asherniedzwiedz-sys/Hatch-Alarm-Clock/Sunrise_Clock_Parts.xlsx

Sheet: Parts
Sunrise Clock: parts, Amazon vs AliExpress |  |  | Total: | $52.03
One clock, every function. Prices checked 2026-10-20 on amazon.com and aliexpress.us (AliExpress: regular price, not the one-time new-shopper deal). Prices change. ESP32 and PLA not included (you have them).
Part | Qty | Amazon listing | Amazon $ | Amazon quality | AliExpress listing | AliExpress $ | AliExpress quality | AliExpress option to pick | Amazon − AliExpress | My pick | My price | Notes
LED strip, WS2812B, 1 m, 10 mm wide | 1 | BTF-Lighting 100 LED/m IP30 (https://www.amazon.com/dp/B088B8G8LD) | $11.99 | 4.6★ | ANTVLED 96 LED/m IP30 (https://www.aliexpress.us/item/3256807796309465.html) | $4.75 | 4.8★, 5,000+ sold | 1m 96 IP30 | $7.24 | AliExpress | $4.75 | BTF is a known brand, consistent color. Ali store 94.8% positive. Both strips fit the channels.
74AHCT125 level shifter (DIP-14) | 1 | 10 pcs (https://www.amazon.com/dp/B08R6BCSYC) | $7.99 | 4.7★ | 5 pcs (https://www.aliexpress.us/item/3256807469514168.html) | $2.41 | 4.9★, 2,000+ sold | 5 pcs | $5.58 | AliExpress | $2.41 | Cheap chips can be relabeled 74HC parts that won't shift 3.3 V to 5 V. First suspect if the LEDs flicker.
MAX98357A I2S amplifier | 1 | 2 pcs (https://www.amazon.com/dp/B0DPJRLMDJ) | $6.88 | 4.5★ | 1 pc (https://www.aliexpress.us/item/3256807442706139.html) | $2.34 | 4.8★, 4,000+ sold |  | $4.54 | AliExpress | $2.34 | Same board design
Speaker, 2" 4 Ω 3 W | 1 | Gikfun EK1725, 2 pcs (https://www.amazon.com/dp/B01CHYIU26) | $11.49 | 4.3★, 776 reviews | SOTAMIA 50 mm, 2 pcs (https://www.aliexpress.us/item/3256808046771474.html) | $7.34 | 528 sold | 4 Ohm 3W | $4.15 | Amazon | $11.49 | Gikfun is better proven. Both fit the seat (glue it in).
DS3231 RTC (ZS-042) | 1 | 2 pcs + jumper wires (https://www.amazon.com/dp/B09LLMYBM1) | $7.99 | 4.4★ | 1 pc, Choice (https://www.aliexpress.us/item/3256806957282138.html) | $3.14 | 4.8★, 4,000+ sold, Choice | DS3231SN, blue board with coin-cell holder | $4.85 | AliExpress | $3.14 | DS3231M chips are less accurate but still work. Remove the charging resistor for a CR2032.
KY-040 rotary encoder | 1 | 5 pcs (https://www.amazon.com/dp/B06XQTHDRR) | $9.39 | 4.5★ | 1 pc + knob (https://www.aliexpress.us/item/2255800145982269.html) | $1.48 | 4.7★, 1,000+ sold |  | $7.91 | AliExpress | $1.48 | Same module, with the pull-ups GPIO34/35 need
12 mm momentary push buttons | 2 | Gebildet 5 pcs, Flat Head (SS-Momentary-5pcs) (https://www.amazon.com/dp/B0B8Z14K3T) | $7.99 | 4.6★, 981 reviews | 1 pc each, price for 2 (https://www.aliexpress.us/item/2251832630370510.html) | $4.40 | 90 sold | Momentary | $3.59 | Amazon | $7.99 | Amazon's are much better reviewed. Weakest AliExpress listing.
USB-C power input, dual 5.1 kΩ | 1 | eleUniverse 2 pcs (https://www.amazon.com/dp/B0GR8SNSCQ) | $8.90 | no reviews yet | Type-C board, CC1/CC2 5.1K, Choice (https://www.aliexpress.us/item/3256805787035895.html) | $2.86 | 5★, 347 sold, Choice | with 5.1K resistors | $6.04 | AliExpress | $2.86 | AliExpress listing has the better track record here
HLK-LD2410C sleep radar | 1 | AEDIKO 2 pcs (https://www.amazon.com/dp/B0GQYYTJPS) | $13.99 | 4.6★, 9 reviews | 1 pc, Choice (https://www.aliexpress.us/item/3256806849046153.html) | $5.91 | 4.8★, 5,000+ sold, Choice | LD2410C (not B or 2420) | $8.08 | AliExpress | $5.91 | Same Hi-Link module. Pocket is 22 × 16 mm: measure yours.
Jumper wires, female-female | 1 | 40 pcs, 20 cm (https://www.amazon.com/dp/B0BRTJQGS6) | $3.99 | 4.8★ | 40 pin (https://www.aliexpress.us/item/3256812379729214.html) | $3.32 |  | F-F 20cm | $0.67 | AliExpress | $3.32 | Same
Protoboards | 1 | 58 pcs kit + headers (https://www.amazon.com/dp/B0CKZ7GFSK) | $13.99 | 4.6★ | 5 pcs (https://www.aliexpress.us/item/3256808585524708.html) | $4.15 | 560 sold | 3x7cm | $9.84 | AliExpress | $4.15 | Amazon kit includes headers and terminals
Total (core build) |  |  | $119.57 |  |  | $51.15 |  |  | $68.42 |  | $58.89 | My price = your mix. Default: AliExpress, except the speaker and buttons from Amazon.
Optional
BH1750 light sensor (auto-dim, optional) | 1 | HiLetgo 3 pcs (https://www.amazon.com/dp/B00M0F29OS) | $7.49 | 4.5★ | GY-302, Choice (https://www.aliexpress.us/item/3256810260002611.html) | $2.19 | 5★, 414 sold, Choice | GY-302 | $5.30 | AliExpress | $2.19 | Only needed for auto-dim
Total with optional parts |  |  | $127.06 |  |  | $53.34 |  |  | $73.72 |  | $61.08
Same on both sites (not in the totals)
OPEN-SMART 0.8" Inch 16x8 I2C LED Dot Matrix Display Module 4 Pin Red LED Matrix for Arduino (https://www.aliexpress.us/item/3256804212916663.html)
Dot-matrix clock: Adafruit 0.8" 8x16 LED Matrix FeatherWing kit, white (https://www.adafruit.com/product/3149) |  |  | $19.95 |  |  |  |  |  |  |  |  | adafruit.com, plus shipping. Neither site had a good match.
…or the yellow version (cheaper) (https://www.adafruit.com/product/3153) |  |  | $11.95 |  |  |  |  |  |  |  |  | adafruit.com, plus shipping
5 V 3 A USB-C power supply (https://www.amazon.com/dp/B09JW4QQJ2) |  |  | $9.99 | think I can find |  |  |  |  |  |  |  | Free if you have a USB-C phone charger that does 5 V 3 A
Fabric: muslin, 1.3 yd (https://www.amazon.com/dp/B0G8HGNHWH) |  |  | $6.99 | can find |  |  |  |  |  |  |  | Free with an old linen shirt or pillowcase. Hold it up to a lamp: it should glow.
CR2032 coin cells, 24 pack (https://www.amazon.com/dp/B0F28618FV) |  |  | $7.99 | can find |  |  |  |  |  |  |  | Free if you have one at home
M3 heat-set inserts | 1 | 100 pcs, M3 × 5.7 × 4.6 (https://www.amazon.com/dp/B0DQL4ZSCP) | $5.99 | can find | brass inserts (https://www.aliexpress.us/item/3256804349544912.html) | $3.40 | 54,000+ sold | M3 (OD 4.5mm) 50pcs, Length 5mm | $2.59 | AliExpress | $3.40 | Holes are Ø4.0 × 5 mm: a 5 mm insert sits flush. OD 5 mm or wider can split the posts.
M3 countersunk screws | 1 | 630 pcs kit (https://www.amazon.com/dp/B0F8HPFXX5) | $8.99 | can find | kit (https://www.aliexpress.us/item/3256805779852270.html) | $5.65 | 4.8★, 1,000+ sold | M3 | $3.34 | AliExpress | $5.65 | Same
470 Ω resistor | 1 | California JOS 100 pcs (https://www.amazon.com/dp/B0B4FSVCPT) | $3.99 | can find | 100 pcs metal film (https://www.aliexpress.us/item/3256809879566136.html) | $1.84 | 550 sold | 470R | $2.15 | AliExpress | $1.84 | Same part
1000 µF 16 V capacitor | 1 | 10 pcs, low ESR (https://www.amazon.com/dp/B0D78PBK4K) | $5.99 | can find | DIP electrolytic (https://www.aliexpress.us/item/3256811625053645.html) | $2.75 | 4.8★, 5,000+ sold | 16V 1000uF | $3.24 | AliExpress | $2.75 | Same part
How to use
Yellow cells (My pick): choose Amazon, AliExpress or None from the dropdown. My price and its total update.
Blue numbers are prices typed in from the listings on 2026-10-20; black numbers are formulas.
Click a listing name to open it. On AliExpress, choose the option in the 'AliExpress option to pick' column.
Quality: most are the same boards on both sites. Amazon = fast, free returns, spares. AliExpress = ~60% cheaper, test parts on arrival.

Sheet: Buying
Sunrise Clock: parts, Amazon vs AliExpress |  |  | Total: | $58.55
One clock, every function. Prices checked 2026-10-20 on amazon.com and aliexpress.us (AliExpress: regular price, not the one-time new-shopper deal). Prices change. ESP32 and PLA not included (you have them).
Part | Qty | listing | Price | My pick | Option to pick
LED strip, WS2812B, 1 m, 10 mm wide | 1 | ANTVLED 96 LED/m IP30 (https://www.aliexpress.us/item/3256807796309465.html) | $4.75 | AliExpress | White PCB, 1m 96 IP30
74AHCT125 level shifter (DIP-14) | 1 | 5 pcs (https://www.aliexpress.us/item/3256807469514168.html) | $2.41 | AliExpress | 5PCS SN74AHCT125N
MAX98357A I2S amplifier | 1 | 1 pc (https://www.aliexpress.us/item/3256807442706139.html) | $2.34 | AliExpress | 1PCS
Speaker, 2" 4 Ω 3 W | 1 | Gikfun EK1725, 2 pcs (https://www.amazon.com/dp/B01CHYIU26) | $11.49 | Amazon | 2 pcs
DS3231 RTC (ZS-042) | 1 | 1 pc, Choice (https://www.aliexpress.us/item/3256806957282138.html) | $3.14 | AliExpress | only one option
KY-040 rotary encoder | 1 | 1 pc + knob (https://www.aliexpress.us/item/2255800145982269.html) | $1.48 | AliExpress | only one option
12 mm momentary push buttons | 2 | Gebildet 5 pcs (pick Flat Head) (https://www.amazon.com/dp/B0B8Z14K3T/) | $7.99 | Amazon | SS-Momentary-5pcs (Flat Head)
USB-C power input, dual 5.1 kΩ | 1 | Type-C board, CC1/CC2 5.1K, Choice (https://www.aliexpress.us/item/3256805787035895.html) | $2.86 | AliExpress | army green (blue board), 1PCS
HLK-LD2410C sleep radar | 1 | 1 pc, Choice (https://www.aliexpress.us/item/3256806849046153.html) | $5.91 | AliExpress | 1pc
Jumper wires, female-female | 1 | 40 pin (https://www.aliexpress.us/item/3256812379729214.html) | $3.32 | AliExpress | 20CM Female-Female, 1Set-40Pin
Protoboards | 1 | 5 pcs (https://www.aliexpress.us/item/3256808585524708.html) | $4.15 | AliExpress | Red 3x7cm, 5PCS
M3 heat-set inserts | 1 | brass inserts (https://www.aliexpress.us/item/3256804349544912.html) | $3.40 | AliExpress | M3 (OD 4.5mm) 50pcs, Length 5mm
Male header pins | 1 | Male header pins (https://www.aliexpress.us/item/3256801327743339.html) | $3.12 |  | 11.5mm 10pcs
Total (core build) |  |  | $56.36
BH1750 light sensor (auto-dim, optional) | 1 | GY-302, Choice (https://www.aliexpress.us/item/3256810260002611.html) | $2.19 | AliExpress | GY-302 1PCS
Total with optional parts |  |  | $58.55
Same on both sites (not in the totals)
Dot Matrix Display (https://www.aliexpress.us/item/3256804212916663.html) | 1 | Dot Matrix Display (https://www.aliexpress.us/item/3256804212916663.html) | $2.82 | AliExpress | most likely buying
Dot-matrix clock: Adafruit 0.8" 8x16 LED Matrix FeatherWing kit, white (https://www.adafruit.com/product/3149) |  |  | $19.95
…or the yellow version (cheaper) (https://www.adafruit.com/product/3153) |  |  | $11.95
5 V 3 A USB-C power supply (https://www.amazon.com/dp/B09JW4QQJ2) |  |  | $9.99 | think I can find
Fabric: muslin, 1.3 yd (https://www.amazon.com/dp/B0G8HGNHWH) |  |  | $6.99 | can find
CR2032 coin cells, 24 pack (https://www.amazon.com/dp/B0F28618FV) |  |  | $7.99 | can find
M3 countersunk screws | 1 | 630 pcs kit (https://www.amazon.com/dp/B0F8HPFXX5) | $8.99 | can find | kit (https://www.aliexpress.us/item/3256805779852270.html) | $5.65 | AliExpress
470 Ω resistor | 1 | California JOS 100 pcs (https://www.amazon.com/dp/B0B4FSVCPT) | $3.99 | can find | 100 pcs metal film (https://www.aliexpress.us/item/3256809879566136.html) | $1.84 | AliExpress
1000 µF 16 V capacitor | 1 | 10 pcs, low ESR (https://www.amazon.com/dp/B0D78PBK4K) | $5.99 | can find | DIP electrolytic (https://www.aliexpress.us/item/3256811625053645.html) | $2.75 | AliExpress
How to use
Yellow cells (My pick): choose Amazon, AliExpress or None from the dropdown. My price and its total update.
Blue numbers are prices typed in from the listings on 2026-10-20; black numbers are formulas.
Click a listing name to open it. On AliExpress, choose the option in the 'AliExpress option to pick' column.
Quality: most are the same boards on both sites. Amazon = fast, free returns, spares. AliExpress = ~60% cheaper, test parts on arrival.
