asherniedzwiedz-sys/Hatch-Alarm-Clock/enclosure/stl/knob.stl

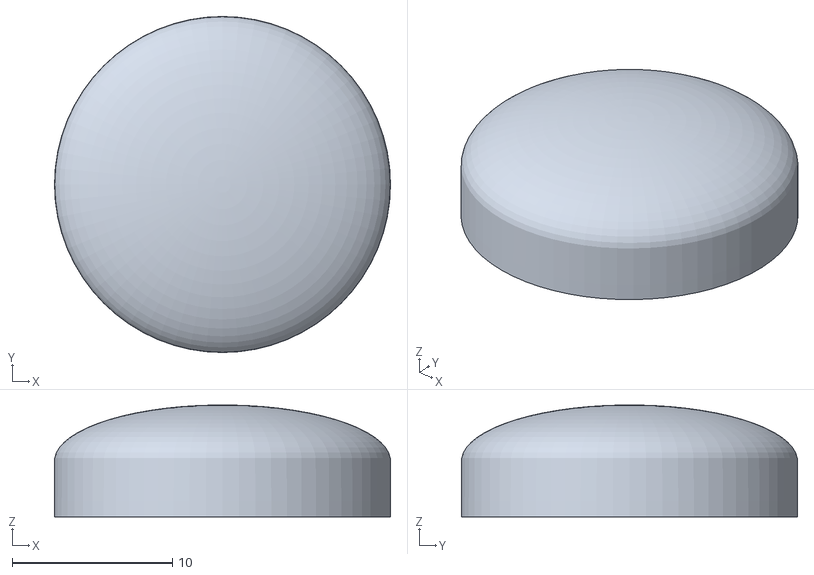
[picture p1: CAD file, 2026-10-21]
enclosure/stl/knob.stl
21.0 x 21.0 x 7.00
