asherniedzwiedz-sys/Hatch-Alarm-Clock/enclosure/sunrise_clock_A1.3mf

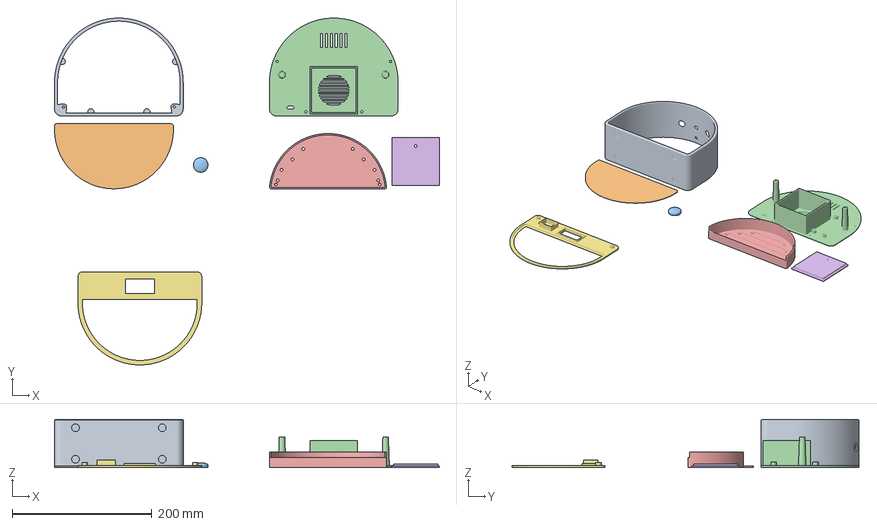
[picture p2: CAD file, 2026-10-21]
enclosure/sunrise_clock_A1.3mf
550.2 x 495.7 x 69.0 mm
diffuser
knob
back_cover
light_box
speaker_lid
frame
