asherniedzwiedz-sys/Hatch-Alarm-Clock/enclosure/stl/speaker_lid.stl

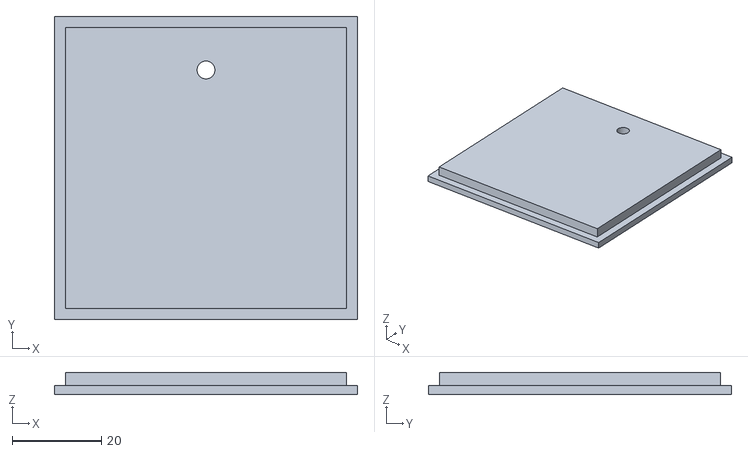
[picture p3: CAD file, 2026-10-21]
enclosure/stl/speaker_lid.stl
68.0 x 68.0 x 5.00
