asherniedzwiedz-sys/Hatch-Alarm-Clock/enclosure/stl/frame.stl

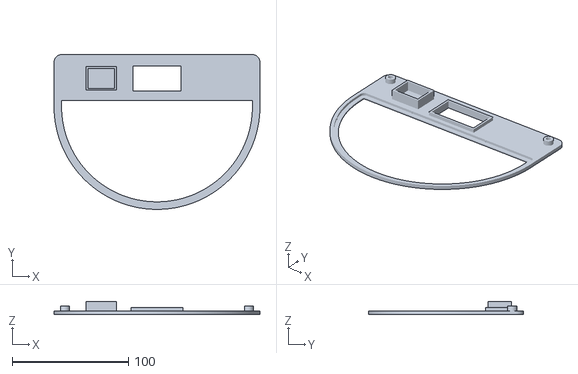
[picture p4: CAD file, 2026-10-21]
enclosure/stl/frame.stl
177.0 x 133.0 x 11.2
