asherniedzwiedz-sys/Hatch-Alarm-Clock/enclosure/stl/back_cover.stl

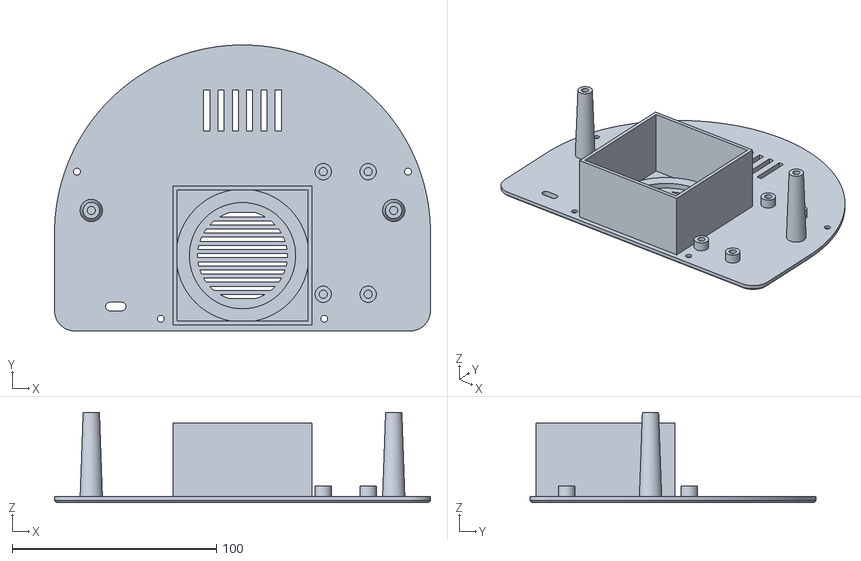
[picture p5: CAD file, 2026-10-21]
enclosure/stl/back_cover.stl
184.0 x 140.0 x 44.1
