asherniedzwiedz-sys/Hatch-Alarm-Clock/enclosure/stl/light_box.stl

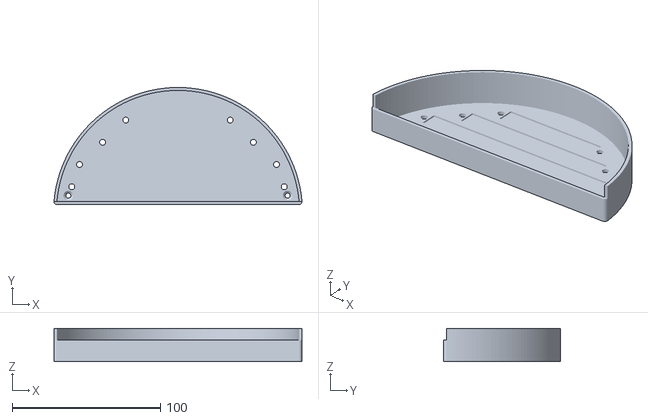
[picture p6: CAD file, 2026-10-21]
enclosure/stl/light_box.stl
167.4 x 79.0 x 22.5
