asherniedzwiedz-sys/Hatch-Alarm-Clock/enclosure/stl/shell.stl

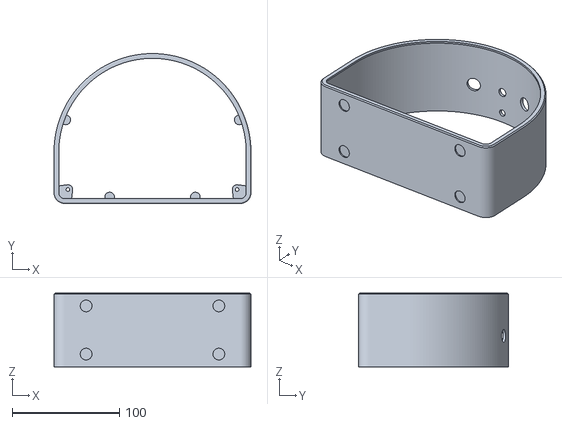
[picture p7: CAD file, 2026-10-21]
enclosure/stl/shell.stl
184.0 x 140.0 x 69.0
