asherniedzwiedz-sys/Hatch-Alarm-Clock/enclosure/stl/diffuser.stl

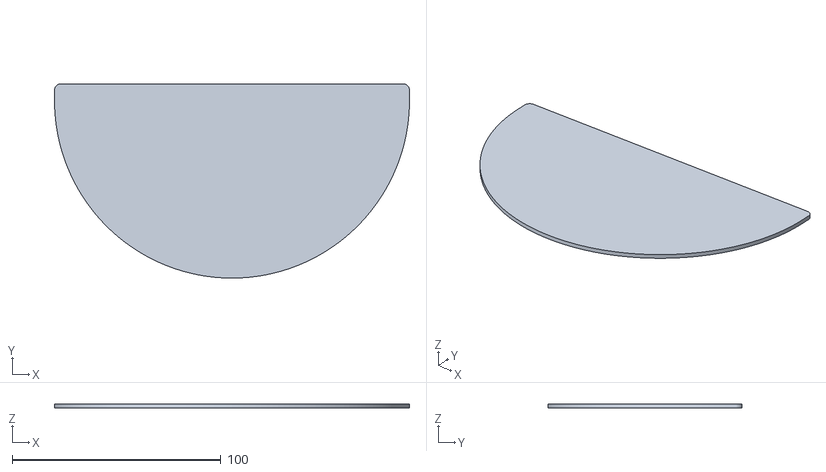
[picture p8: CAD file, 2026-10-20]
enclosure/stl/diffuser.stl
170.0 x 93.0 x 2.00
