asherniedzwiedz-sys/Hatch-Alarm-Clock/(commit log)

2026-10-20 Hatch-style DIY sunrise alarm clock: firmware, web UI, enclosure
    ESP32 firmware (PlatformIO, Arduino-ESP32 2.0.17): 30-min sunrise ramp,
    synthesized chime, SD sleep sounds with sleep timer, night light, DS3231 RTC
    alarms in NVS, dot-matrix clock, LD2410C radar sleep tracking, web UI + OTA.
    OpenSCAD arch enclosure with exported STLs, assembly guide and check script.
    [back_cover.stl, diffuser.stl, frame.stl, knob.stl, light_box.stl, shell.stl, speaker_lid.stl, sunrise_clock.scad]
2026-10-20 Bambu Studio project: all parts on 3 plates for the A1
    sunrise_clock_A1.3mf puts the 7 STLs on 3 plates (white x2, black frame) with
    Bambu's 0.20mm Standard @BBL A1 settings and two PLA Basic slots. make_3mf.py
    rebuilds it from the STLs and checks every part is manifold, on its plate and
    not overlapping. Script paths are now cwd-relative.
    [sunrise_clock_A1.3mf]
2026-10-20 Fit the model to the parts on the shopping list; add PARTS.md
    - Speaker seat for the Gikfun 2" 4 ohm 3 W (no 57 mm driver on Amazon).
    - LED rows for the BTF-Lighting 100 LED/m, 10 mm strip (still 13/12/9/6).
    - Clock pocket is a 3 mm rim so the Adafruit FeatherWing board clears it;
    that board runs from 3V3, so no I2C level shifter.
    - PARTS.md: checked Amazon picks with links, and what isn't on Amazon.
    [back_cover.stl, frame.stl, knob.stl, light_box.stl, shell.stl, speaker_lid.stl, sunrise_clock.scad, sunrise_clock_A1.3mf]
2026-10-20 Shell: corner screw bosses become columns from the print bed
    Bambu Studio flagged a floating cantilever: the frame's corner bosses had flat
    undersides ~20 mm wide, 45 mm above the bed when printed back-down. They now
    rise straight from the back rim, with a countersunk seat (45 deg ceiling) and a
    driver channel from the open back. overhangs.py checks every STL for surfaces
    that need support.
    [back_cover.stl, frame.stl, knob.stl, light_box.stl, shell.stl, speaker_lid.stl, sunrise_clock.scad, sunrise_clock_A1.3mf]
2026-10-21 Built-in sleep sounds: synthesize white/pink/rain/ocean/fan on the ESP32
    The SD module and card are now optional (only for your own WAVs), which cuts
    ~$27 and their wiring. SoundSynth.h is pure and tested natively: each sound
    sits at -20 dBFS +-2 dB with no DC or clipping. PARTS.md gets a lean build.
2026-10-21 Parts: Amazon vs AliExpress comparison; LED channels fit 96 and 100/m
    PARTS.md compares the lean build part by part: $129.55 on Amazon vs $50.41 on
    AliExpress (plus the Adafruit clock on either), with quality notes. The light
    box channels are sized for 96 LED/m, so the AliExpress strip fits and the
    Amazon 100/m strip still does.
    [back_cover.stl, frame.stl, knob.stl, light_box.stl, shell.stl, speaker_lid.stl, sunrise_clock.scad, sunrise_clock_A1.3mf]
2026-10-21 Add the parts list as an Excel workbook
    Sunrise_Clock_Parts.xlsx: every part with Amazon and AliExpress links, prices
    and quality notes, a per-part pick dropdown, and live totals. Recalculated in
    Excel: 40 formulas, no errors.
    [Sunrise_Clock_Parts.xlsx]
2026-10-21 Swap four AliExpress parts to Choice listings
    Single-seller listings each charged $4-6 shipping; Choice items ship
    together. Radar, RTC, USB-C board and light sensor updated in the
    spreadsheet and PARTS.md.
    [Sunrise_Clock_Parts.xlsx]
2026-10-21 Parts: final buy list, OPEN-SMART I2C clock
    PARTS.md gets the checked final list with the option to pick per
    listing. The clock is now the OPEN-SMART 0.8" 16x8 I2C board
    (HT16K33-compatible), with Adafruit's FeatherWing as the alternative.
    Buttons link to the Flat Head listing, the USB-C board option is the
    blue one with visible CC resistors, and the inserts are M3 OD 4.5 x 5 mm.
    The workbook adds the Buying tab, with tracking parameters stripped
    from the links.
    [Sunrise_Clock_Parts.xlsx]
2026-10-21 Screw lengths: allowed range per spot, checked against the model
    The ESP32 standoffs take M3x5-6 (M3x8 bottoms out in the 6 mm hole
    under a 1.6 mm board). The back cover and light box take M3x6-8
    (M3x10 bottoms out). The shopping list is now 2 x M3x10, 6 x M3x8 and
    4 x M3x6 instead of 10 x M3x8.
2026-10-21 Workbook: fix circular totals and stale Parts-tab cells
    Parts row 16 summed rows 5-30, which included itself, so its totals
    came out blank. It now sums the part rows plus the inserts and
    screws. The Parts tab also gets the $4.75 strip price, the Flat Head
    button link, and the M3 OD 4.5 x 5 mm insert at $3.40, matching the
    Buying tab.
    [Sunrise_Clock_Parts.xlsx]
2026-10-21 Clock: find the board at any address 0x70-0x77; log brownout resets
    Clone HT16K33-type boards (e.g. the OPEN-SMART 16x8 I2C) may ship
    with different address jumpers, so begin() now tries the whole range
    and prints where it answered. Boot also says when the last reset was a
    brownout, the likeliest failure at full light plus chime plus Wi-Fi.
    Builds with 0 warnings; 15/15 native tests pass.
    [ClockDisplay.cpp, ClockDisplay.h, Config.h, main.cpp]
2026-10-21 Bench test guide and Wokwi simulation
    BENCH_TEST.md walks through testing before soldering: first in the
    Wokwi simulator (no parts needed), then module by module on the desk.
    The wokwi env builds with -DWOKWI and merges bootloader, partitions,
    app and the LittleFS web page into one image (tools/wokwi_merge.py).
    Simulator-only behavior: join Wokwi-GUEST, accept the localhost port
    forward, and add a one-time alarm 3 minutes out so the sunrise and
    ring can be checked right away. The real build is unchanged apart
    from 3 amber blinks after a brownout reset.
    Both envs build with 0 warnings; 15/15 native tests pass. The
    simulation itself hasn't been run here (it needs a Wokwi license).
    Co-Authore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
    [AlarmScheduler.h, WebUI.cpp, main.cpp]
2026-10-22 Wokwi: drive 2 LEDs; print alarm phase changes
    In the simulator the 40-LED strip stayed dark with the firmware while
    an Adafruit NeoPixel test sketch lit it on the same wiring. 2 LEDs fit
    one RMT memory block, so the sim build no longer depends on refill
    interrupts. Untested in Wokwi yet. Phase changes now go to serial in
    both builds, for the bench test.
    [Config.h, main.cpp]
2026-10-22 Wokwi: no SNTP, so the RTC's local time doesn't jump to UTC mid-test
    The simulator's DS1307 starts at the PC's local time, which the firmware
    reads as UTC. SNTP then corrected it by the UTC offset, the 3-minute test
    alarm moved hours away, and the sunrise ended after a few seconds.
    [WebUI.cpp]
2026-10-22 Wokwi: light the first LED with neopixelWrite instead of NeoPixelBus
    In the simulator, pin 16 carried NeoPixelBus's RMT signal but the strip
    stayed dark, even at 2 LEDs, while an Adafruit test sketch (pre-built
    RMT items) lit it. On this core both libraries use the RMT sample
    translator; the core's neopixelWrite() sends pre-built items, so the sim
    build uses it for the first LED. The real build still drives all 40 LEDs
    through NeoPixelBus. Reverts the 2-LED sim count.
    [Config.h, LightEngine.cpp, LightEngine.h]
2026-10-22 Serial: button presses, boot button levels and timestamped alarm phases
    The simulator showed sunrise -> idle seconds after boot with nothing
    pressed. These lines tell a phantom dismiss press from a clock jump, and
    help the real bench test too.
2026-10-22 Buttons: a button held at power-up is not a press
    In Wokwi both buttons were wired across one contact pair, so they read
    pressed from boot; the debouncer started at 'released' and reported a
    press, which dismissed the resumed sunrise. Start each button at its
    real level, so a stuck or held button can't dismiss an alarm on reboot.
    [InputHandler.cpp]
